tyehle/sunrise/firmware/normalization/white.png

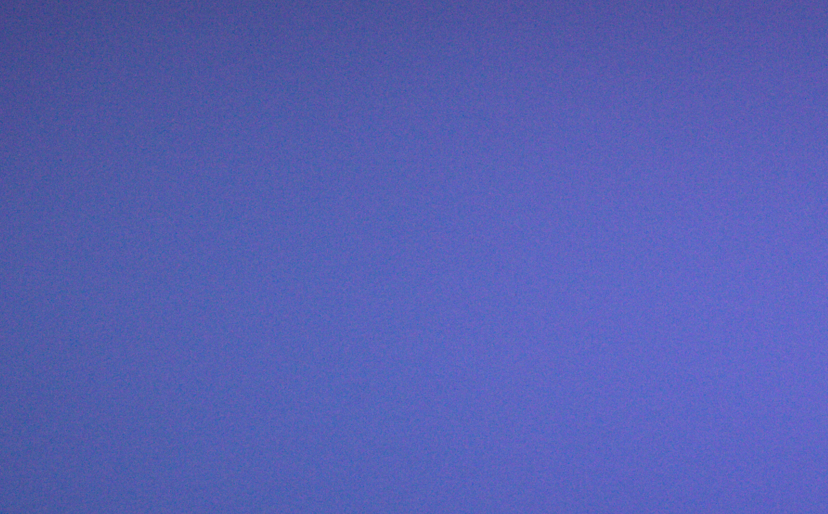
firmware/normalization/white.png
