tyehle/sunrise/hardware/sunrise-board.kicad_pcb

## KiCad design hardware/sunrise-board.kicad_pcb (2020-05-10)

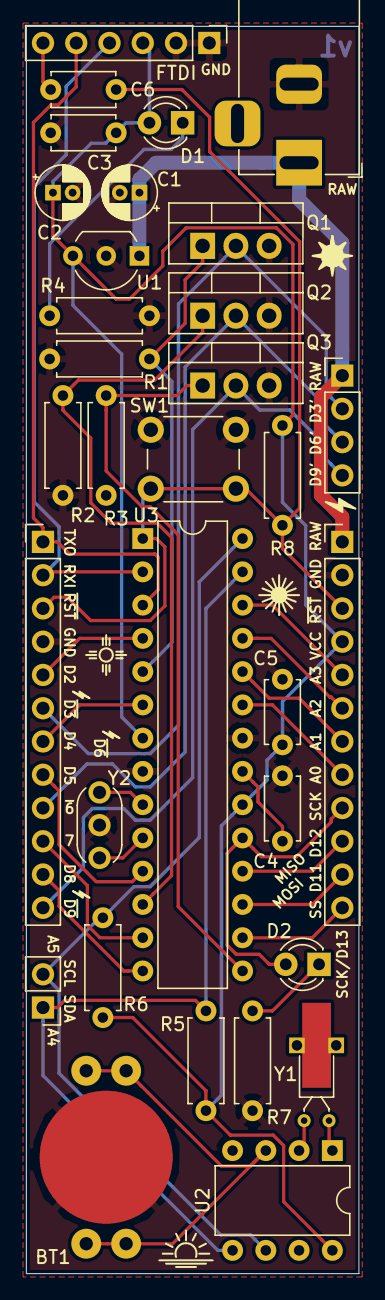
[picture p2: board sunrise-board.kicad_pcb from above]

Board: 2 copper layers, 25.4 x 95.2 mm, 32 parts (0 on the bottom side), 36 nets.

Parts:
BT1: CR1220 3.3V; BatteryHolder_CR1220_THT
C1, C2: 10uF; CP_Radial_D4.0mm_P1.50mm
C3, C4, C5, C6: 0.1uF; C_Disc_D4.7mm_W2.5mm_P5.00mm
D1, D2: LED; LED_D3.0mm
J1: Barrel Jack 12V; BarrelJack_Horizontal
J2, J4: Header; PinHeader_1x12_P2.54mm_Vertical
J3: FTDI Basic; PinHeader_1x06_P2.54mm_Vertical
J5: LED_STRIP_VGRB; PinHeader_1x04_P2.54mm_Vertical
J6: I2C; PinHeader_1x02_P2.54mm_Vertical
Q1, Q2, Q3: IRLZ34N; TO-220-3_Vertical
R1, R2, R3: 10k; R_Axial_DIN0207_L6.3mm_D2.5mm_P7.62mm_Horizontal
R4, R5, R6, R8: 10K; R_Axial_DIN0207_L6.3mm_D2.5mm_P7.62mm_Horizontal
R7: 330; R_Axial_DIN0207_L6.3mm_D2.5mm_P7.62mm_Horizontal
SW1: Reset; SW_PUSH_6mm
U1: L4931CZ50-AP; TO-92_Inline_Wide
U2: DS1307+; DIP-8_W7.62mm
U3: ATmega328P-PU; DIP-28_W7.62mm
Y1: 32.768kHz; Crystal_C26-LF_D2.1mm_L6.5mm_Horizontal_1EP_style2
Y2: 16MHz; Resonator-3Pin_W6.0mm_H3.0mm

Connections:
A0: J4.8, U3.23
A1: J4.7, U3.24
A2: J4.6, U3.25
A3: J4.5, U3.26
D2: J2.5, U3.4
D4: J2.7, U3.6
D5: J2.8, U3.11
D7: J2.10, U3.13
D8: J2.11, U3.14
D10: J4.12, U3.16
DTR: C6.2, J3.6
GND: BT1.2, C1.2, C2.2, C3.2, C4.2, C5.2, J1.2, J2.4, J3.1, J3.2, J4.2, Q1.3, Q2.3, Q3.3, R1.2, R2.2, R3.2, R4.2, R7.1, SW1.1, U1.2, U2.4, U3.8, U3.22, Y2.2
LED_B: J2.12, J5.4, Q3.2
LED_CTL_B: Q3.1, R3.1, U3.15
LED_CTL_G: Q2.1, R2.1, U3.12
LED_CTL_R: Q1.1, R1.1, U3.5
LED_G: J2.9, J5.3, Q2.2
LED_R: J2.6, J5.2, Q1.2
MISO: J4.10, U3.18
MOSI: J4.11, U3.17
unnamed: BT1.1, U2.3
unnamed: C4.1, U3.21
unnamed: D1.1, R4.1
unnamed: D2.1, R7.2
unnamed: U2.1, Y1.1
unnamed: U2.2, Y1.2
unnamed: U3.9, Y2.3
unnamed: U3.10, Y2.1
RAW: C1.1, J1.1, J4.1, J5.1, U1.1
RESET: C6.1, J2.3, J4.3, R8.2, SW1.2, U3.1
RXI: J2.2, J3.4, U3.2
SCK: D2.2, J4.9, U3.19
SCL: J6.2, R6.2, U2.6, U3.28
SDA: J6.1, R5.2, U2.5, U3.27
TXO: J2.1, J3.5, U3.3
VCC: C2.1, C3.1, C5.1, D1.2, J3.3, J4.4, R5.1, R6.1, R8.1, U1.3, U2.8, U3.7, U3.20
