tyehle/sunrise/firmware/firmware.ino

#include <math.h>
#include <Wire.h>

#include "RTClib.h"

#include "pwm.h"

#define DATA_SIZE 36


float colorData[DATA_SIZE][4] = {
  {1000,1.0,0.0401,0.0},
  {1100,1.0,0.0631,0.0},
  {1200,1.0,0.086,0.0},
  {1300,1.0,0.1085,0.0},
  {1400,1.0,0.1303,0.0},
  {1500,1.0,0.1515,0.0},
  {1600,1.0,0.1718,0.0},
  {1700,1.0,0.1912,0.0},
  {1800,1.0,0.2097,0.0},
  {1900,1.0,0.2272,0.0},
  {2000,1.0,0.2484,0.0061},
  {2100,1.0,0.2709,0.0153},
  {2200,1.0,0.293,0.0257},
  {2300,1.0,0.3149,0.0373},
  {2400,1.0,0.3364,0.0501},
  {2500,1.0,0.3577,0.064},
  {2600,1.0,0.3786,0.079},
  {2700,1.0,0.3992,0.095},
  {2800,1.0,0.4195,0.1119},
  {2900,1.0,0.4394,0.1297},
  {3000,1.0,0.4589,0.1483},
  {3100,1.0,0.4781,0.1677},
  {3200,1.0,0.497,0.1879},
  {3300,1.0,0.5155,0.2087},
  {3400,1.0,0.5336,0.2301},
  {3500,1.0,0.5515,0.252},
  {3600,1.0,0.5689,0.2745},
  {3700,1.0,0.586,0.2974},
  {3800,1.0,0.6028,0.3207},
  {3900,1.0,0.6193,0.3444},
  {4000,1.0,0.6354,0.3684},
  {4100,1.0,0.6511,0.3927},
  {4200,1.0,0.6666,0.4172},
  {4300,1.0,0.6817,0.4419},
  {4400,1.0,0.6966,0.4668},
  {4500,1.0,0.7111,0.4919}
//  {4600,1.0,0.7253,0.517},
//  {4700,1.0,0.7392,0.5422},
//  {4800,1.0,0.7528,0.5675},
//  {4900,1.0,0.7661,0.5928},
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
};

// Output Pins
int red = 9;
int green = 6;
int blue = 3;

/*
 * FFFFFF output = 87, 97, 185
 * normalized white = 255, 229, 120
 */
double rMax = 255 / 256.0;
double gMax = 229 / 256.0;
double bMax = 120 / 256.0;

uint32_t wakeTime;
uint32_t upTime;
uint32_t dayTime;
uint32_t offTime;

RTC_DS1307 rtc;

// flash once with this set to reset the clock, then flash again with
// it false so the board doesn't set the clock on every boot
bool reset_clock = false;

void setup() {
  Serial.begin(115200);

  if(!rtc.begin()) {
    Serial.println("Couldn't find RTC");
    exit(1);
  }

  if(!rtc.isrunning() || reset_clock) {
    Serial.println("Resetting RTC clock!");
    // set the time to the time this was compiled
    rtc.adjust(DateTime(F(__DATE__), F(__TIME__)) + TimeSpan(14)); // it takes ~14 seconds to program and reset the board
    // set an explicit date and time
//    rtc.adjust(DateTime(2019, 6, 25, 20, 16, 0));
  }
  Serial.print("Now: "); printlnDate(rtc.now());

  // Setup the output channels
  setupPWM16();
  writePWM(red, 0.0);
  writePWM(green, 0.0);
  writePWM(blue, 0.0);

  wakeTime = daySeconds(DateTime(1970, 1, 1, 8, 30, 0));
  // wakeTime = daySeconds(DateTime(F(__DATE__), F(__TIME__)) + TimeSpan(17));
  upTime   = wakeTime + 60*30;
  dayTime  = upTime + 60*60;
  offTime  = dayTime + 60*30;

  // // wakeTime = daySeconds(DateTime(1970, 01, 01, 10, 2, 00));
  // wakeTime = daySeconds(DateTime(F(__DATE__), F(__TIME__)) + TimeSpan(17));
  // upTime   = wakeTime + 60;
  // dayTime  = upTime + 20;
  // offTime  = dayTime + 60;

  Serial.print("Hour:   "); Serial.println(rtc.now().hour());
  Serial.print("Minute: "); Serial.println(rtc.now().minute());
  Serial.print("Second: "); Serial.println(rtc.now().second());
  Serial.print("Now Seconds:  "); Serial.println(daySeconds(rtc.now()));
  Serial.print("Wake Seconds: "); Serial.println(wakeTime);
  Serial.print("Up Seconds:   "); Serial.println(upTime);
  Serial.print("Day Seconds:  "); Serial.println(dayTime);
  Serial.print("Off Seconds:  "); Serial.println(offTime);
}



// Brightness scalar [0, 1] for a time on [0, 1]
double brightness(double t) {
  double k = 0.125;
  double a = log(1/k + 1);
  return k * (exp(t * a) - 1);
}

// Brightness [0, 1] of a color channel (1, 2, 3) for a time t on [0, 1]
double color(int channel, double b, double h) {
  double howBright = brightness(b);
  double dataTime = h * (DATA_SIZE - 1);

  double low = colorData[(int) dataTime][channel];
  double high = colorData[(int) dataTime + 1][channel];

  double colorBrightness = low + (high - low)*(dataTime - ((int)dataTime));

  return colorBrightness * howBright;
}

// Set the lights for a time value on [0, 1]
void setLights(double power, double hue, bool chatty) {
  if(power < 0) power = 0;
  if(power > 1) power = 1;
  if(hue < 0) hue = 0;
  if(hue > 1) hue = 1;

  double r = color(1, power, hue) * rMax;
  double g = color(2, power, hue) * gMax;
  double b = color(3, power, hue) * bMax;

  if(chatty) {
    Serial.print(power); Serial.print(",\t");
    Serial.print(hue); Serial.print(",\t");
    Serial.print(r); Serial.print(",\t");
    Serial.print(g); Serial.print(",\t");
    Serial.print(b); Serial.print("\n");
  }

  writePWM(red, r);
  writePWM(green, g);
  writePWM(blue, b);
}




void printlnDate(DateTime date) {
  char out[21];
  sprintf(out, "%04d-%02d-%02dT%02d:%02d:%02d\n",
          date.year(), date.month(), date.day(),
          date.hour(), date.minute(), date.second());
  Serial.print(out);
}

uint32_t daySeconds(DateTime date) {
  return (uint32_t)date.hour() * 3600 + date.minute() * 60 + date.second();
}



void flashGreen() {
  writePWM(green, 1.0/255.0);
  delay(250);
  writePWM(green, 0);
}



void loop() {
//  flashGreen();
//  while(true) {}

  // What mode are we in?
  uint32_t now = daySeconds(rtc.now());
  if(wakeTime <= now && now < upTime) {
    Serial.println("Waking up");
    doUpdate(1, true, wakeTime, upTime - wakeTime);
  } else if(upTime <= now && now < dayTime) {
    Serial.println("Holding");
    doUpdate(2, false, upTime, dayTime - upTime);
  } else if(dayTime <= now && now < offTime) {
    Serial.println("powering down");
    doUpdate(3, true, dayTime, offTime - dayTime);
  } else {
    Serial.println("Off");
    doUpdate(0, false, offTime, wakeTime + (24*60*60) - offTime);
  }
}


void doUpdate(uint8_t mode, bool hiRes, long modeStartTime, long modeLenth) {
  double howFar = daySeconds(rtc.now()) - modeStartTime;
  long startTime = millis();
  long elapsed = 0;
  double t;
  bool shouldTalk = true;

  do {
    t = (howFar + (elapsed/1000.0)) / (double)modeLenth;
    setModeLights(mode, t, shouldTalk);
    shouldTalk = false;

    if(!hiRes) {
      delay(1000);
    }

    elapsed = millis() - startTime;
  } while(elapsed < 1000);
}

void setModeLights(uint8_t mode, double t, bool chatty) {
  switch(mode) {
    // Off
    case 0:
      setLights(0, 0, false);
      break;

    // Wake
    case 1:
      setLights(t, t, chatty);
      break;

    // On
    case 2:
      setLights(1, 1, false);
      break;

    // Fade
    case 3:
      setLights(1 - t, 1, chatty);
  }
}
