tyehle/sunrise/(commit log)

2018-11-22 add color python test bed
2018-11-23 write colors to a data file
    [sunrise.csv]
2018-11-23 arduino project
2019-06-01 small fixes to firmware
    [rgb.ino]
2019-06-01 schematic done
    [sunrise-board.kicad_pcb, sunrise-board.sch]
2019-06-01 print the schematic
    [sunrise-board.sch]
2019-06-02 update schematic and assign some footprints
    [sunrise-board.sch]
2019-06-03 finish assigning footprints
    [sunrise-board.sch]
2019-06-03 netlist and licences info
    [sunrise-board.sch]
2019-06-03 update schematic pdf
2019-06-03 all nets and board outline done
    [sunrise-board.sch]
2019-06-04 fill and silk screen done
    [sunrise-board.kicad_pcb, sunrise-board.sch]
2019-06-05 updates to silk screen
    [sunrise-board-B.Cu.gbl, sunrise-board-B.Mask.gbs, sunrise-board-B.SilkS.gbo, sunrise-board-Edge.Cuts.gm1, sunrise-board-F.Cu.gtl, sunrise-board-F.Mask.gts, sunrise-board-F.SilkS.gto, sunrise-board-NPTH.drl]
2019-06-14 update gerbers to include fab layer
    [sunrise-board-B.Cu.gbl, sunrise-board-B.Fab.gbr, sunrise-board-B.Mask.gbs, sunrise-board-B.SilkS.gbo, sunrise-board-F.Cu.gtl, sunrise-board-F.Fab.gbr, sunrise-board-F.Mask.gts, sunrise-board-F.SilkS.gto]
2019-06-14 change schematic to svg
2019-06-14 add board renders
2019-06-25 finish bom and docs
    [sunrise-board.csv, sunrise-board.sch]
2019-06-25 update schematic
2019-06-26 update assembly doc
2019-06-27 update code for board
2020-05-08 rename and clean up the hardware project
    [sunrise-board-B.Cu.gbl, sunrise-board-B.Fab.gbr, sunrise-board-B.Mask.gbs, sunrise-board-B.SilkS.gbo, sunrise-board-Edge.Cuts.gm1, sunrise-board-F.Cu.gtl, sunrise-board-F.Fab.gbr, sunrise-board-F.Mask.gts]
2020-05-08 move the firmware to its own folder
    [sunrise.csv]
2020-05-10 fix crystal value
    [sunrise-board-B.Cu.gbl, sunrise-board-B.Fab.gbr, sunrise-board-B.Mask.gbs, sunrise-board-B.SilkS.gbo, sunrise-board-Edge.Cuts.gm1, sunrise-board-F.Cu.gtl, sunrise-board-F.Fab.gbr, sunrise-board-F.Mask.gts]
2020-05-14 smooth out the startup using the 16 bit pwm
2020-05-15 make just recipes for build and upload using the arduino-cli
2020-05-15 add a green flash and fix the 16 bit PWM writing
    [firmware.ino]
2020-05-15 move the pwm logic to its own file
2020-05-17 fix bugs with pwm file
    [pwm.cpp]
2020-05-17 fix issues with the new way of triggering the lights
    [firmware.ino]
2020-05-21 fix an overflow bug
    [firmware.ino]
2020-06-07 fix the fonts on the color plots
    [colors.py]
