tyehle/sunrise/(notices)

Notices in the files:
hardware/sunrise-board.sch:
Licence: CC BY-NC-SA
hardware/sunrise-board.kicad_pcb:
License: CC BY-NC-SA
